pfe-rs/lk-s-2022-robot-valjak/Prezentacija/IMG_20220919_164024.jpg

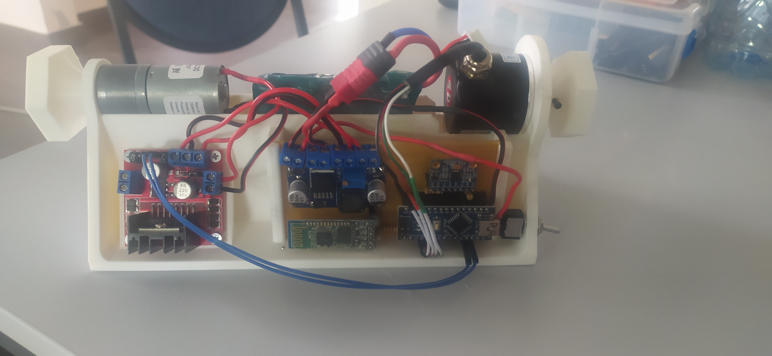
Prezentacija/IMG_20220919_164024.jpg
