pfe-rs/lk-s-2022-robot-valjak/Prezentacija/Robot Valjak.pptx

## Robot Valjak

Filip Bajraktari
Nikola Ristanović
Mentor: Đorđe Marjanović & Bojan roško

## Dinamika sistema

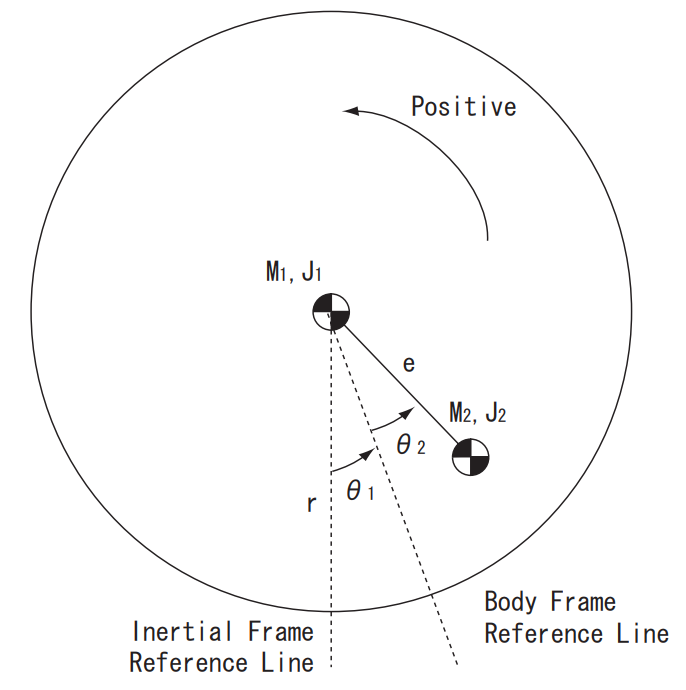
[picture p2: figure]

## Odskočni odzivi sistema

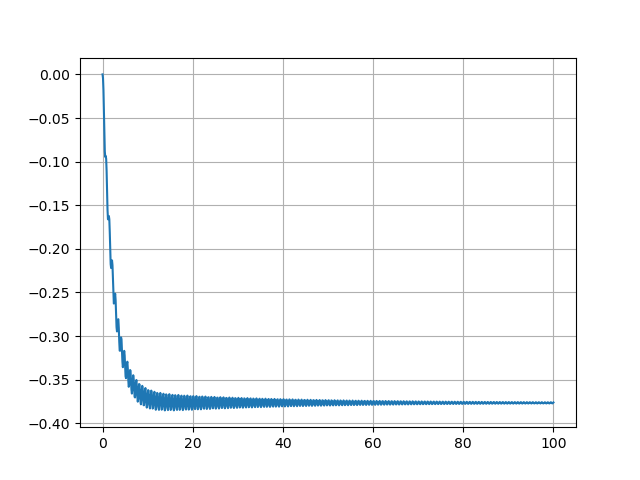
[picture p3: figure]

Ugaona brzina robota od napona motora

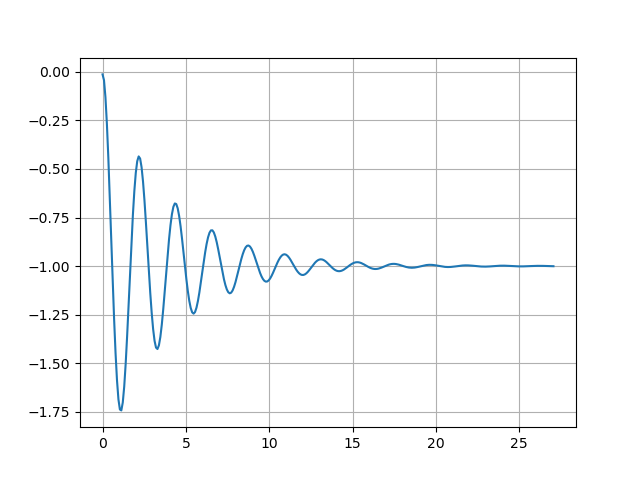
[picture p4: figure]

Ugaona brzina robota od ugaone brzine motora

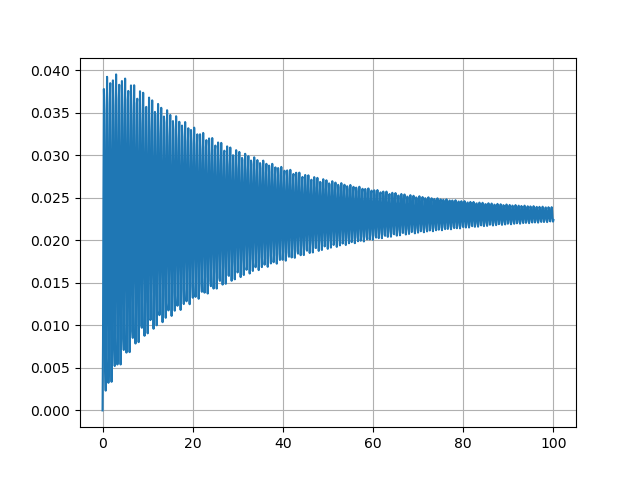
[picture p5: figure]

Ugao inklinacije klatna od napona motora

## Simulacije PID kontrolera

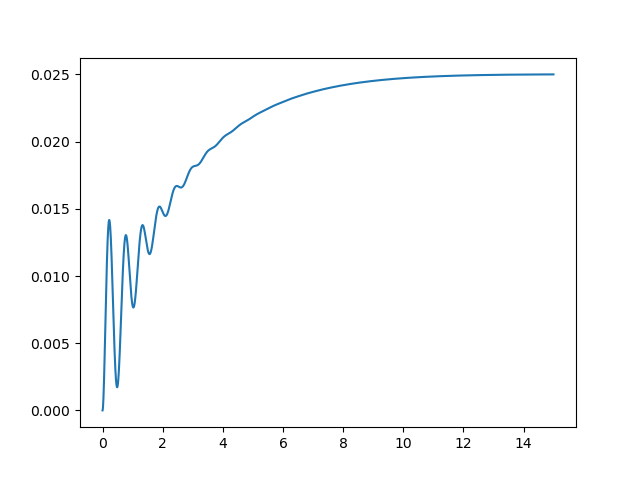
[picture p6: figure]

Ugao inklinacije klatna od vremena

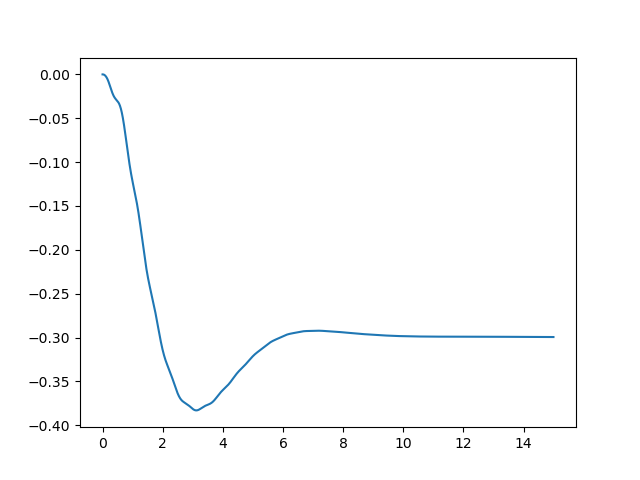
[picture p7: figure]

Ugaona brzina robota od vremena

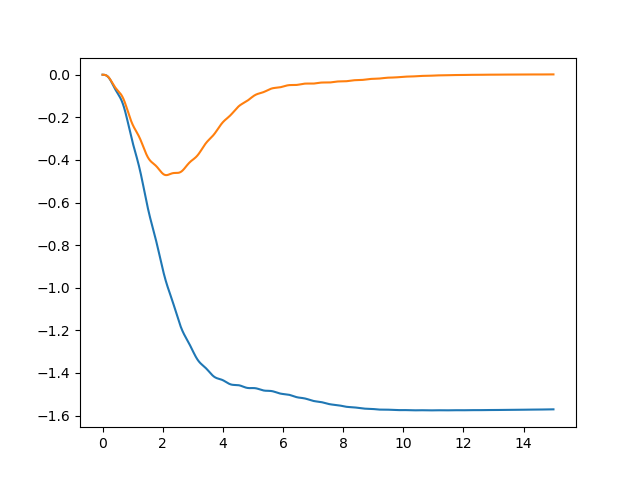
[picture p8: figure]

Ugaoni pomeraj valjka od vremena

## Block diagram

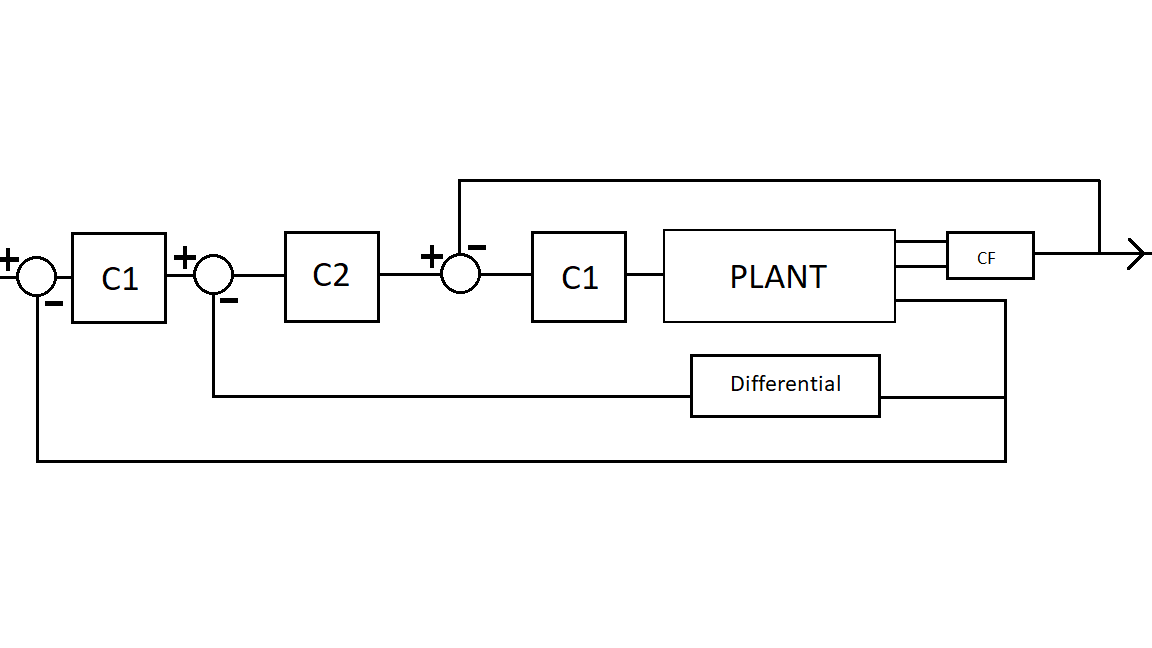
[picture p9: figure]

## Slide 6

Rotary optical encoder

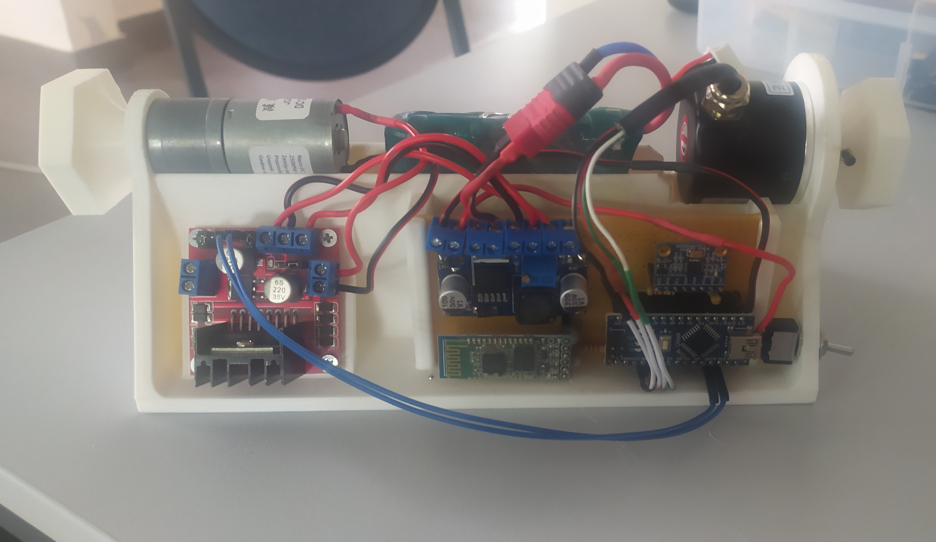
[picture p10: figure]

DC Motor

Li-ion battery

DC-DC stepdown converter

Motor driver

Arduino Nano

HC 06 Bluetooth module

MPU6050

## Slide 7

Elekatrična šema

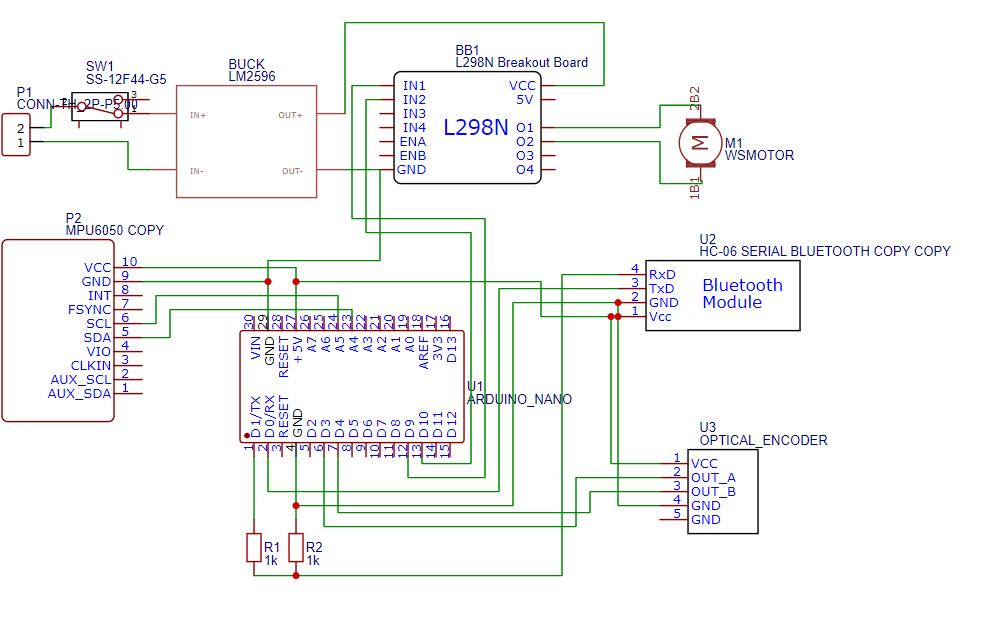
[picture p11: figure]

## Merenje odskočnog odziva sistema

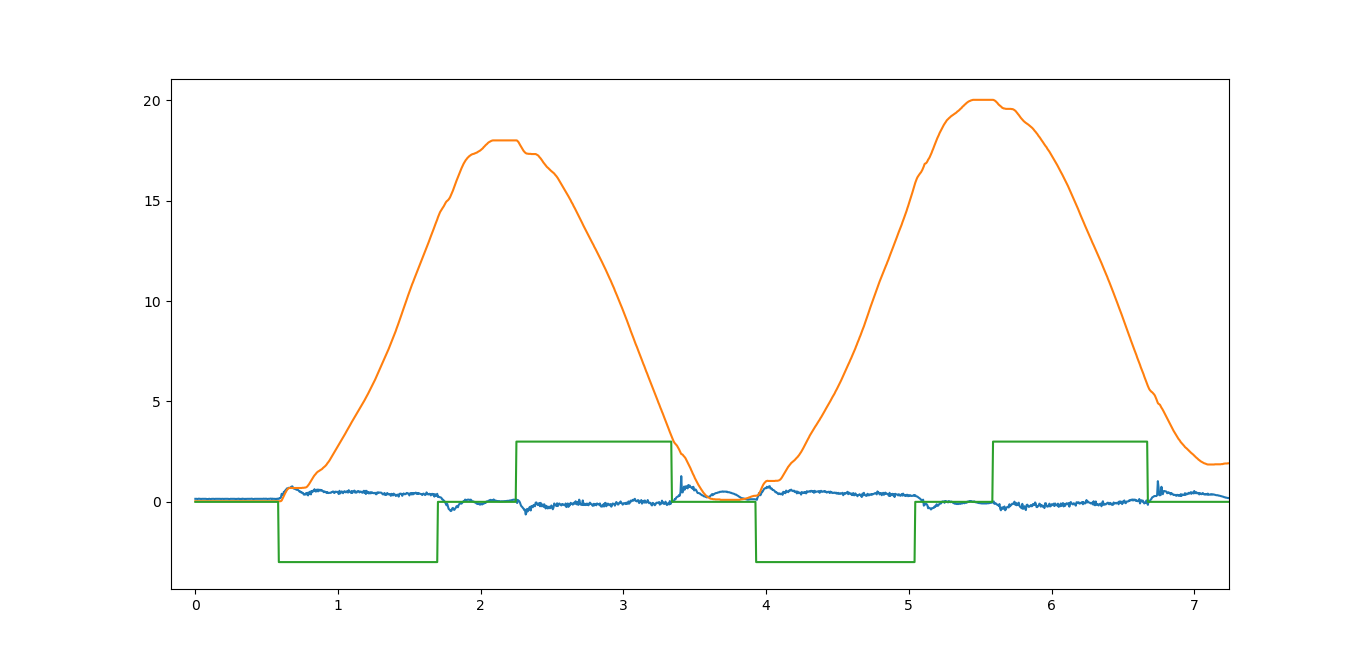
[picture p12: figure]

## PITANJA?
