pfe-rs/lk-s-2022-robot-valjak/HARDWARE/Model1.jpg

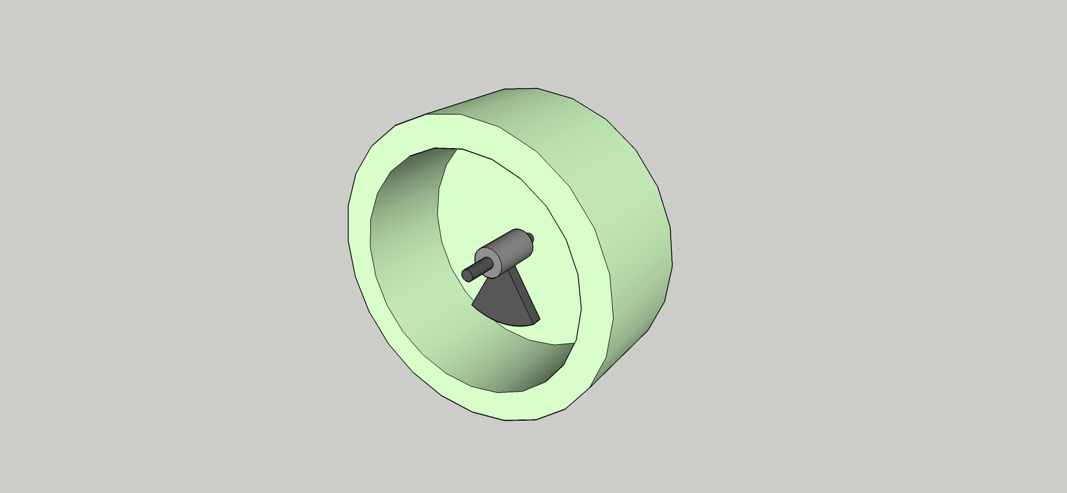
HARDWARE/Model1.jpg
