pfe-rs/lk-s-2022-robot-valjak/HARDWARE/view1.jpg

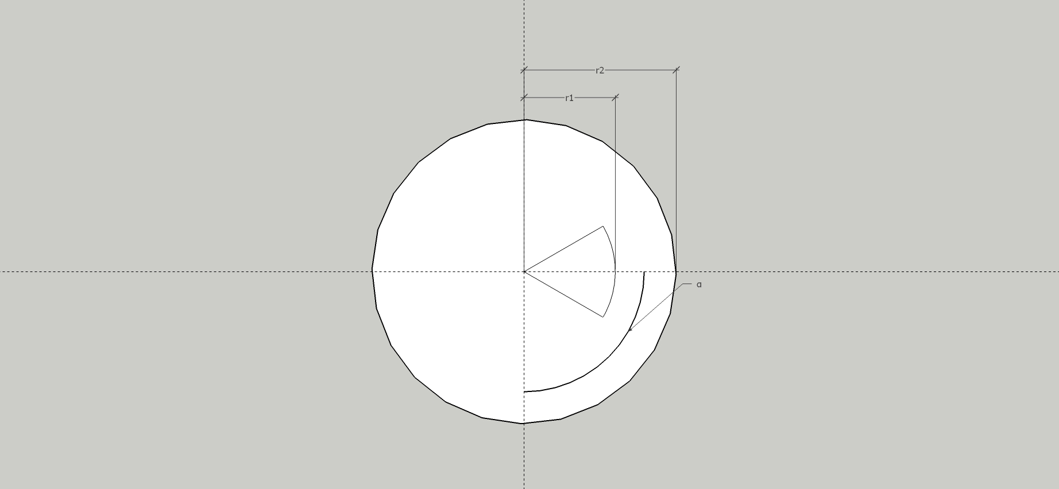
HARDWARE/view1.jpg
