pfe-rs/lk-s-2022-robot-valjak/(list of files, cad)

Other CAD files:
HARDWARE/Model1.skp
