pfe-rs/lk-s-2022-robot-valjak/ValjakV2R2/Robot_valjak_interface/Robot_valjak_interface.pde

import processing.serial.*;
Serial port;

import org.gamecontrolplus.gui.*;
import org.gamecontrolplus.*;
import net.java.games.input.*;

ControlIO control;
Configuration config;
ControlDevice gpad;


boolean demo = false;
boolean controlerPresent = true;



void setup() {
  fullScreen();
  //size(1000, 500);
  surface.setResizable(true);

  System.setProperty("net.java.games.input.useDefaultPlugin", "false");

  control = ControlIO.getInstance(this);
  gpad = control.getMatchedDevice("speed");

  //controller check
  if (gpad == null) {
    println("No controller detected, arrow keys only");
    controlerPresent = false;
  }


  if (!demo) {
    String portName = "COM8";
    port = new Serial(this, portName, 9600);
    port.clear();
    // Throw out the first reading, in case we started reading
    // in the middle of a string from the sender.
  };


  frameRate(500);
}

void draw() {
  getData();
  getControlerInput();
  getArrowKeys();

  //println("d" + dataOut);
  if (!demo) {
    if (frameCount % 5 == 0) {
      port.write(str(dataOut));
      port.write('\n');
    }
  }

  drawScreen();
}
