pfe-rs/lk-s-2022-robot-valjak/(commit log)

2022-09-11 Hardware commit stl files & more
    [Model1.skp]
2022-09-11 added complementary filter
2022-09-12 cleanup of imu functions
2022-09-12 firs part of the simulation - wihtout PID
2022-09-13 PID simulation
2022-09-14 code cleanup and PID simulation and graphical simulation
2022-09-14 Rista syncup
    [data.csv]
2022-09-14 arduino-python serial data transmission and csv files
    [data.csv]
2022-09-14 little changes
    [test.csv]
2022-09-16 PID simulation of angular velocity of the robot
2022-09-17 PID simulations
2022-09-17 ispravka svega zivog
    [data.csv]
2022-09-18 data collector
    [data.csv]
2022-09-18 data collector 2
    [data.csv]
2022-09-18 Added hacked PID controller
2022-09-18 system identification with measurements
    [test.csv]
2022-09-18 all four measurements plus input voltage
    [data.csv, data2.csv]
2022-09-18 final PID
2022-09-18 grey box model
    [data2.csv]
2022-10-14 Added all 3 PID controllers Fixed a bug in the arduino code caused by integer overflow Fixed a bug in the interface caused by lack of string characters Cleaned up the arduino code
    [data.csv]
2022-11-11 Added bluetooth and joystick capabilities
    [speedMax.xlsx]
